haxeko/c3-wroom-air-quality/hardware/cost/price_db_and_boq.xlsx

Sheet: Kho gia
KHO GIÁ LINH KIỆN – dự án cảm biến PM2.5 (ESP32-C3)
Nguồn: đơn hàng Taobao (shop 优信电子), theo 2 ảnh chụp “Chi tiết đơn hàng”. Ngày cập nhật: 28/10/2026. |  |  |  |  |  |  |  |  |  |  |  |  | Tỷ giá USD → VND: | 26500 đ/USD
Giả định: số tiền ở mỗi dòng đơn hàng là THÀNH TIỀN của cả dòng (đã nhân số lượng), không phải đơn giá. Linh kiện dán bán theo gói 1件 = 50 chiếc (ghi trên ảnh sản phẩm).
Ô chữ xanh dương = số nhập tay từ đơn hàng (sửa được). Cột “Đơn giá / chiếc” tự tính = Thành tiền ÷ (SL mỗi gói × Số gói).
Dòng “Ước tính” (nền cam nhạt): chưa mua, giá tham khảo LCSC / thị trường quy ra VND theo tỷ giá ở ô O2. Khi mua thật, sửa Thành tiền và đổi Loại giá thành “Thực mua”.
ID | Tên linh kiện | Mã hàng / MPN | Thông số | Kiểu chân | SL mỗi gói (chiếc) | Số gói mua | Thành tiền (VND) | Tổng số chiếc | Đơn giá / chiếc (VND) | Nguồn | Ngày cập nhật | Dùng cho board PM2.5 | Ghi chú | Giá tham khảo (USD / chiếc) | Loại giá
LK001 | IC ổn áp AMS1117-3.3 | UMW AMS1117-3.3 | 3.3 V, 1 A | SOT-223 | 1 | 20 | 14256 đ | 20 | 712.8 đ | Taobao – 优信电子 | 28/10/2026 | Có | U2 |  | Thực mua
LK002 | Board ESP32-C3-SuperMini (chưa hàn chân) | ESP32-C3-SuperMini | Board phát triển | Module | 1 | 2 | 97416 đ | 2 | 48708.0 đ | Taobao – 优信电子 | 28/10/2026 | Không | Dùng thử nghiệm, không nằm trên board PM2.5 |  | Thực mua
LK003 | Tụ gốm 10 µF | Samsung CL21A106KAYNNNE | 10 µF ±10% 25 V X5R | 0805 | 50 | 1 | 46966 đ | 50 | 939.3 đ | Taobao – 优信电子 | 28/10/2026 | Có | C4, C16 |  | Thực mua
LK004 | Tụ gốm 22 µF | Samsung CL21A226MAQNNNE | 22 µF ±20% 25 V X5R | 0805 | 50 | 1 | 200337 đ | 50 | 4006.7 đ | Taobao – 优信电子 | 28/10/2026 | Có | C1, C3, C7 – lô đã mua (50 chiếc, đủ ~16 board). Lần mua sau dùng loại 16 V (LK028) |  | Thực mua
LK005 | Tụ gốm 100 nF | Samsung CL10B104KB8NNNC | 100 nF ±10% 50 V X7R | 0603 | 50 | 1 | 19642 đ | 50 | 392.8 đ | Taobao – 优信电子 | 28/10/2026 | Có | C2, C8, C10–C14, C18 |  | Thực mua
LK006 | Tụ gốm 1 µF | Samsung CL10B105KA8NNNC | 1 µF ±10% 25 V X7R | 0603 | 50 | 1 | 15920 đ | 50 | 318.4 đ | Taobao – 优信电子 | 28/10/2026 | Có | C6, C17 |  | Thực mua
LK007 | Điện trở 5.1 kΩ | UNI-ROYAL 0603WAF5101T5E | 5.1 kΩ ±1% 1/10 W | 0603 | 50 | 1 | 5307 đ | 50 | 106.1 đ | Taobao – 优信电子 | 28/10/2026 | Có | R1, R2 |  | Thực mua
LK008 | Điện trở 10 kΩ | UNI-ROYAL 0603WAF1002T5E | 10 kΩ ±1% 1/10 W | 0603 | 50 | 1 | 5307 đ | 50 | 106.1 đ | Taobao – 优信电子 | 28/10/2026 | Có | R3, R4, R5 |  | Thực mua
LK009 | Điện trở 4.7 kΩ | UNI-ROYAL 0603WAF4701T5E | 4.7 kΩ ±1% 1/10 W | 0603 | 50 | 1 | 5307 đ | 50 | 106.1 đ | Taobao – 优信电子 | 28/10/2026 | Có | R8, R9 (kéo lên I2C, có hàn) |  | Thực mua
LK010 | Điện trở 330 Ω | ROYALOHM 0603 3300 | 330 Ω ±1% 1/10 W | 0603 | 50 | 1 | 5307 đ | 50 | 106.1 đ | Taobao – 优信电子 | 28/10/2026 | Có | R7. Giả định gói 50 chiếc như các điện trở khác (ảnh không ghi) |  | Thực mua
LK011 | Điện trở 100 kΩ | UNI-ROYAL 0603WAF1003T5E | 100 kΩ ±1% 1/10 W | 0603 | 50 | 1 | 5307 đ | 50 | 106.1 đ | Taobao – 优信电子 | 28/10/2026 | Không | Không có trên board PM2.5 |  | Thực mua
LK012 | Cổng USB-C cái 6P | Type-C母座_6P_4脚插板7.4 | 6 chân, 4 chân vỏ xuyên lỗ, chỉ cấp nguồn | SMD + THT | 1 | 10 | 12672 đ | 10 | 1267.2 đ | Taobao – 优信电子 | 28/10/2026 | Không | Đã mua nhưng board v20 dùng cổng JLC hàn sẵn (LK029) |  | Thực mua
LK013 | Màn OLED 1.3" SH1106 | 1.3寸OLED显示屏_4针_白色 | 128×64, I2C 4 chân, chữ trắng | Module | 1 | 5 | 236016 đ | 5 | 47203.2 đ | Taobao – 优信电子 | 28/10/2026 | Có | Cắm vào J3 |  | Thực mua
LK014 | Board ESP32-H2-SuperMini | ESP32-H2-SuperMini | Board phát triển | Module | 1 | 2 | 158559 đ | 2 | 79279.5 đ | Taobao – 优信电子 | 28/10/2026 | Không | Không có trên board PM2.5 |  | Thực mua
LK015 | Module ESP32-C3-N4 (tương thích WROOM-02) | ESP32-C3-N4 (兼容 ESP32-C3-WROOM-02) | Wi-Fi + BLE, flash 4 MB | Module SMD | 1 | 10 | 373230 đ | 10 | 37323.0 đ | Taobao – giỏ hàng (chưa đặt) | 28/10/2026 | Có | Giá hiển thị 36.234 đ/chiếc (¥9,15); tổng giỏ 373.230 đ cho 10 chiếc (cao hơn 10 × đơn giá khoảng 10.890 đ, có thể là phí). Module tương thích, cần kiểm tra kích thước và chân khớp footprint WROOM-02 |  | Giỏ hàng
LK016 | LDO AP2112K-3.3 | Diodes AP2112K-3.3TRG1 (LCSC C51118) | 3.3 V 600 mA | SOT-23-5 | 1 | 1 | 450 đ | 1 | 450.0 đ | Giá chủ dự án cung cấp | 28/10/2026 | Có | Giá 450 đ / chiếc |  | Giá báo
LK017 | LED RGB XL-1615RGBC-WS2812B | XINGLIGHT XL-1615RGBC-WS2812B (LCSC C5349954) | RGB có IC, 1.6 x 1.5 mm | SMD 1615 | 1 | 1 | 300 đ | 1 | 300.0 đ | Giá chủ dự án cung cấp | 28/10/2026 | Có | 300 đ/chiếc là giá bạn báo cho LED 2020 trước đây; cập nhật khi có giá loại 1615 |  | Giá báo
LK018 | Cầu chì tự phục hồi 1.1 A | SMD1206-110 / SMD1206B110TFT | Giữ 1.1 A, ngắt 2.2 A, 6–8 V | 1206 | 1 | 1 | 600 đ | 1 | 600.0 đ | Giả định của chủ dự án | 28/10/2026 | Không | Không dùng cầu chì trên board (pad F1 nối tắt) |  | Ước tính
LK019 | Nút nhấn TS-1187A-B-A-B | XKB TS-1187A-B-A-B (LCSC C318884) | 5.1 x 5.1 mm, JLC Basic | SMD | 1 | 1 | 506.15 đ | 1 | 506.1 đ | Ước tính – LCSC | 28/10/2026 | Có | Giá LCSC khoảng 0,019 USD | 0.0191 USD | Ước tính
LK020 | Giắc JST-PH 2.0 4P đứng | B4B-PH-K-S (loại tương thích) | 4 chân, bước 2.0 mm, có khoá | THT | 1 | 1 | 600 đ | 1 | 600.0 đ | Giả định của chủ dự án | 28/10/2026 | Có | Nhóm giắc, nút, cầu chì giả định ~3.000 đ / sản phẩm, chia đều 600 đ cho 5 món (BOQ dùng 2 giắc) |  | Ước tính
LK021 | Header đực 1×6 2.54 mm + jumper | Header 1×6 + jumper 2.54 | 2.54 mm | THT | 1 | 1 | 600 đ | 1 | 600.0 đ | Giả định của chủ dự án | 28/10/2026 | Có | Nhóm giắc, nút, cầu chì giả định ~3.000 đ / sản phẩm, chia đều 600 đ cho 5 món |  | Ước tính
LK022 | Cảm biến bụi PMS5003 + đế chuyển + cáp | 攀藤 PMS5003+转接板+连接线 | PM1.0 / PM2.5 / PM10, UART 5 V; kèm đế chuyển và cáp | Module | 1 | 4 | 1022760 đ | 4 | 255690.0 đ | Taobao – đơn hàng đã nhận | 24/10/2026 | Có | Tiền hàng 1.013.760 đ + ship 9.000 đ cho 4 bộ (đã tính ship vào đơn giá) |  | Thực mua
LK023 | Module cảm biến CO2 SCD40 | Module SCD40 (I2C) | CO2 + nhiệt độ + độ ẩm | Module | 1 | 1 | 255000 đ | 1 | 255000.0 đ | Giá chủ dự án cung cấp | 28/10/2026 | Có | Giá 255.000 đ / module |  | Giá báo
LK024 | Cáp PH2.0 4P có dây sẵn | Cáp PH2.0 4P | Dài ~10–15 cm | Cáp | 1 | 1 | 2120 đ | 1 | 2120.0 đ | Ước tính – LCSC / thị trường | 28/10/2026 | Có | Ước tính | 0.08 USD | Ước tính
LK025 | PCB 2 lớp 51,4×31,4 mm (1 tấm) | JLCPCB 2 lớp 1.6 mm | Gia công PCB trần | PCB | 1 | 1 | 10600 đ | 1 | 10600.0 đ | Ước tính – LCSC / thị trường | 28/10/2026 | Có | Ước tính ~2 USD / 5 tấm, chưa gồm phí ship | 0.40 USD | Ước tính
LK026 | Vít M2 | Vít M2 (2 vít nhựa phía anten) | M2 | Vít | 1 | 1 | 530 đ | 1 | 530.0 đ | Ước tính – LCSC / thị trường | 28/10/2026 | Có | Ước tính | 0.02 USD | Ước tính
LK027 | Vỏ hộp in 3D | Nhựa PLA ~40 g | Tự in 3D | Vỏ | 1 | 1 | 12000 đ | 1 | 12000.0 đ | Ước tính – LCSC / thị trường | 28/10/2026 | Có | Chỉ tiền nhựa nếu tự in; thuê in sẽ cao hơn |  | Ước tính
LK028 | Tụ gốm 22 µF 16 V | Samsung CL21A226MOQNNNE (LCSC C98190) | 22 µF ±20% 16 V X5R | 0805 | 1 | 1 | 662.5 đ | 1 | 662.5 đ | Ước tính – LCSC / thị trường | 28/10/2026 | Có | Thay tụ 22 µF 25 V cho C1, C3, C7 (cùng footprint 0805). Giá ước tính, sửa khi mua thật | 0.025 USD | Ước tính
LK029 | Cổng USB-C 16P (JLC hàn) | HX TYPE-C 16PIN (LCSC C2927039) | 16P, chỉ dùng VBUS/GND/CC | SMD + chân vỏ xuyên lỗ | 1 | 1 |  | 1 | 0.0 đ | JLCPCB | 28/10/2026 | Có | Chưa có giá – xem trên công cụ BOM của JLC rồi nhập vào Thành tiền |  | Chưa có giá
 |  |  |  |  |  | Tổng tiền đơn hàng | 1851079 đ

Sheet: BOQ 1 san pham
BOQ – GIÁ THÀNH 1 SẢN PHẨM CẢM BIẾN PM2.5 (Air Quality V1.0)
Ô nền vàng, chữ xanh dương = nhập tay đơn giá cho linh kiện chưa có trong Kho giá (VND / chiếc). Để trống = chưa có giá.
Chữ xanh lá = đơn giá tự lấy từ sheet “Kho gia” theo cột Mã kho. Cột SL / sản phẩm sửa được (chữ xanh dương).
Thành tiền = SL × Đơn giá áp dụng. Trạng thái: “Đã có giá” = giá thực mua; “Giá ước tính” = chưa mua, giá tham khảo trong Kho gia.
STT | Nhóm | Ký hiệu | Mô tả | SL / sản phẩm | Mã kho | Đơn giá nhập tay (VND) | Đơn giá áp dụng (VND) | Thành tiền (VND) | Trạng thái | Ghi chú
1 | Linh kiện trên board | U1 | Module ESP32-C3-N4 (tương thích ESP32-C3-WROOM-02) | 1 | LK015 |  | 37323.0 đ | 37323 đ | Đã có giá | Tự hàn, không đặt JLC (mua riêng trên Taobao)
2 | Linh kiện trên board | U2 | IC ổn áp AMS1117-3.3, SOT-223 | 1 | LK001 |  | 712.8 đ | 712.8 đ | Đã có giá
3 | Linh kiện trên board | U6 | LDO AP2112K-3.3 (nguồn riêng SCD40), SOT-23-5 | 1 | LK016 |  | 450.0 đ | 450 đ | Đã có giá
4 | Linh kiện trên board | LED1–LED3 | LED RGB XL-1615RGBC-WS2812B (1.6 x 1.5 mm) | 3 | LK017 |  | 300.0 đ | 900 đ | Đã có giá
5 | Linh kiện trên board | C1, C3, C7 | Tụ 22 µF 16 V X5R 0805 | 3 | LK028 |  | 662.5 đ | 1987.5 đ | Giá ước tính
6 | Linh kiện trên board | C4, C16 | Tụ 10 µF 25 V X5R 0805 | 2 | LK003 |  | 939.3 đ | 1878.64 đ | Đã có giá
7 | Linh kiện trên board | C2, C8, C10–C12, C18 | Tụ 100 nF 50 V X7R 0603 | 6 | LK005 |  | 392.8 đ | 2357.04 đ | Đã có giá
8 | Linh kiện trên board | C6, C17 | Tụ 1 µF 25 V X7R 0603 | 2 | LK006 |  | 318.4 đ | 636.8 đ | Đã có giá
9 | Linh kiện trên board | R1, R2 | Điện trở 5.1 kΩ 1% 0603 (CC USB-C) | 2 | LK007 |  | 106.1 đ | 212.28 đ | Đã có giá
10 | Linh kiện trên board | R3, R4, R5 | Điện trở 10 kΩ 1% 0603 | 3 | LK008 |  | 106.1 đ | 318.42 đ | Đã có giá
11 | Linh kiện trên board | R7 | Điện trở 330 Ω 1% 0603 (data LED) | 1 | LK010 |  | 106.1 đ | 106.14 đ | Đã có giá
12 | Linh kiện trên board | R8, R9 | Điện trở 4.7 kΩ 1% 0603 (kéo lên I2C) | 2 | LK009 |  | 106.1 đ | 212.28 đ | Đã có giá | Có hàn (song song điện trở kéo lên trên module, vẫn trong mức an toàn)
13 | Linh kiện trên board | F1 | Điện trở 0 Ω 1206 thay cầu chì (JLC C17888) | 1 |  | 60 đ | 60.0 đ | 60 đ | Đã có giá | Ước tính khoảng 60 đ
14 | Linh kiện trên board | SW2 | Nút nhấn TS-1187A-B-A-B (JLC Basic) | 1 | LK019 |  | 506.1 đ | 506.15 đ | Giá ước tính
15 | Linh kiện trên board | J1 | Cổng USB-C 16P HX (JLC C2927039, JLC hàn) | 1 | LK029 |  | 0.0 đ | 0 đ | Chưa có giá
16 | Linh kiện trên board | J2B, J4 | Giắc JST-PH 2.0 mm 4P cắm đứng | 2 | LK020 |  | 600.0 đ | 1200 đ | Giá ước tính
17 | Linh kiện trên board | J5 | 6 pad nạp (không còn header + jumper) | 0 | LK021 |  | 600.0 đ | 0 đ | Không dùng | Đã đổi thành pad trên board, không tốn linh kiện
18 | Module & cảm biến | J3 | Màn OLED 1.3" SH1106 I2C | 1 | LK013 |  | 47203.2 đ | 47203.2 đ | Đã có giá
19 | Module & cảm biến | — | Cảm biến bụi PMS5003 (kèm đế chuyển + cáp) | 1 | LK022 |  | 255690.0 đ | 255690 đ | Đã có giá
20 | Module & cảm biến | — | Module cảm biến CO2 SCD40 | 1 | LK023 |  | 255000.0 đ | 255000 đ | Đã có giá
21 | Module & cảm biến | — | Cáp JST-PH 4P có dây (PMS5003, SCD40) | 2 | LK024 |  | 2120.0 đ | 4240 đ | Giá ước tính
22 | PCB & gia công | — | PCB trần (giá 1 tấm theo báo giá JLCPCB) | 1 | LK025 |  | 10600.0 đ | 10600 đ | Giá ước tính | Thay bằng tổng tiền PCB ÷ số tấm khi có báo giá
23 | PCB & gia công | — | Phí lắp ráp SMT JLC (chia cho 1 tấm) | 0 |  |  | 0.0 đ | 0 đ | Không dùng | Mặc định 0 = tự hàn. Nếu JLC hàn: SL = 1, nhập phí, và linh kiện JLC cấp không tính lại ở trên
24 | Vỏ & vật tư phụ | H1–H4 | Vít M2 (2 con bên phải nên là vít nhựa) | 4 | LK026 |  | 530.0 đ | 2120 đ | Giá ước tính
25 | Vỏ & vật tư phụ | — | Vỏ hộp | 1 | LK027 |  | 12000.0 đ | 12000 đ | Giá ước tính
 |  |  | TỔNG HỢP
 |  |  | Linh kiện trên board |  |  |  |  | 48861.05 đ | 1 dòng chưa có giá
 |  |  | Module & cảm biến |  |  |  |  | 562133.2 đ | 0 dòng chưa có giá
 |  |  | PCB & gia công |  |  |  |  | 10600 đ | 0 dòng chưa có giá
 |  |  | Vỏ & vật tư phụ |  |  |  |  | 14120 đ | 0 dòng chưa có giá
 |  |  | GIÁ THÀNH 1 SẢN PHẨM |  |  |  |  | 635714.25 đ | 1 dòng chưa có giá
 |  |  | trong đó: theo giá thực mua |  |  |  |  | 603060.6 đ
 |  |  | trong đó: theo giá ước tính |  |  |  |  | 32653.65 đ
 |  |  | Giá ước tính đổi theo tỷ giá ở ô O2 sheet Kho gia. Khi mua thật, cập nhật Kho gia là BOQ tự tính lại.
