haxeko/c3-wroom-air-quality/hardware/mechanical/board_outline.dxf

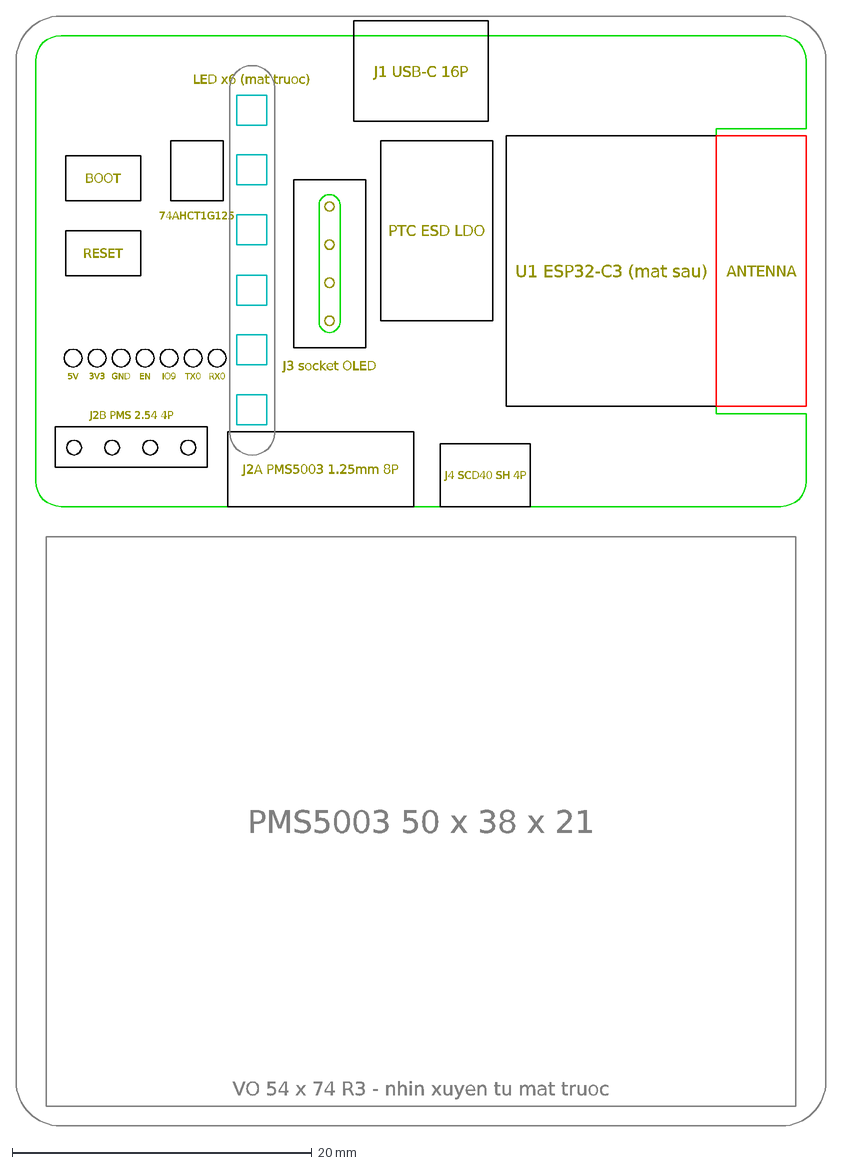
[picture p2: CAD file, 2026-11-11]
hardware/mechanical/board_outline.dxf
LED x6 (mat truoc)
U1 ESP32-C3 (mat sau)
ANTENNA
J1 USB-C 16P
PTC ESD LDO
J3 socket OLED
74AHCT1G125
BOOT
RESET
5V
3V3
GND
EN
IO9
TX0
RX0
J2B PMS 2.54 4P
J2A PMS5003 1.25mm 8P
J4 SCD40 SH 4P
PMS5003 50 x 38 x 21
VO 54 x 74 R3 - nhin xuyen tu mat truoc
