haxeko/c3-wroom-air-quality/hardware/kicad/led2020/pm25_LED2020.kicad_pcb

## KiCad design hardware/kicad/led2020/pm25_LED2020.kicad_pcb (2026-11-11)

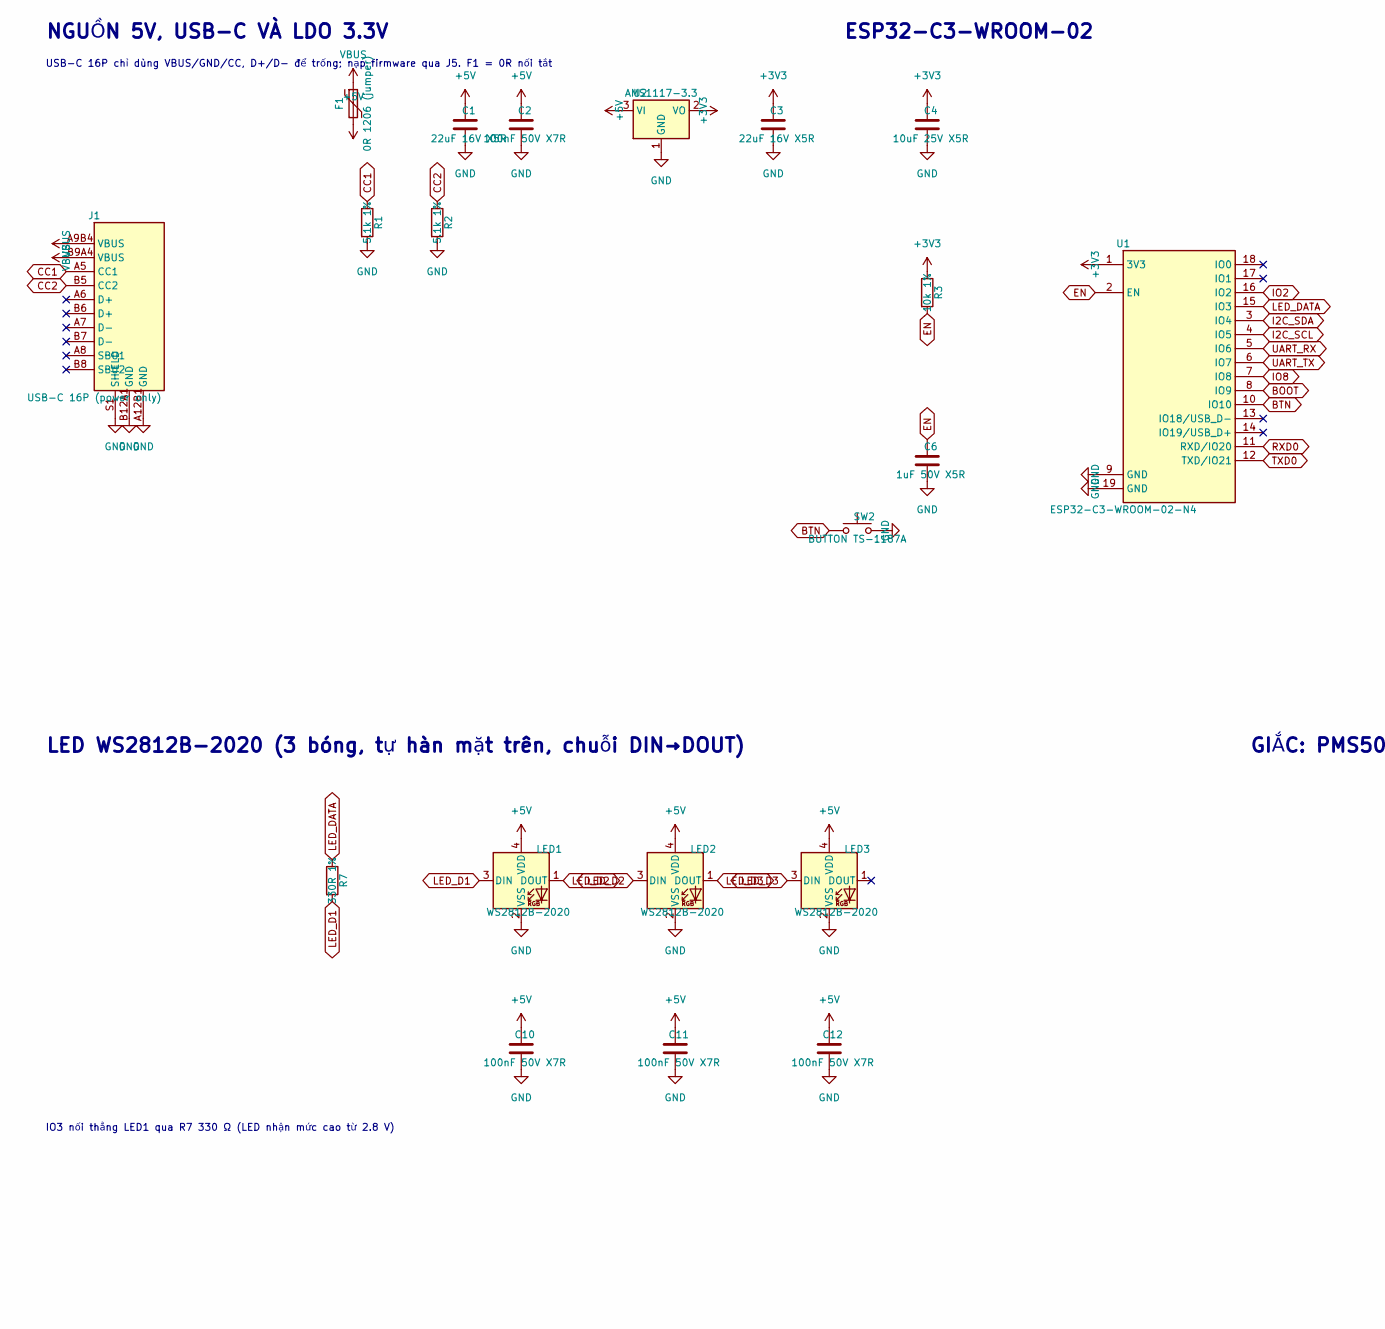
[picture p15: schematic pm25_LED2020.kicad_sch, Cảm biến bụi PM2.5 - ESP32-C3 - LED2020, part in row 1, column 1]

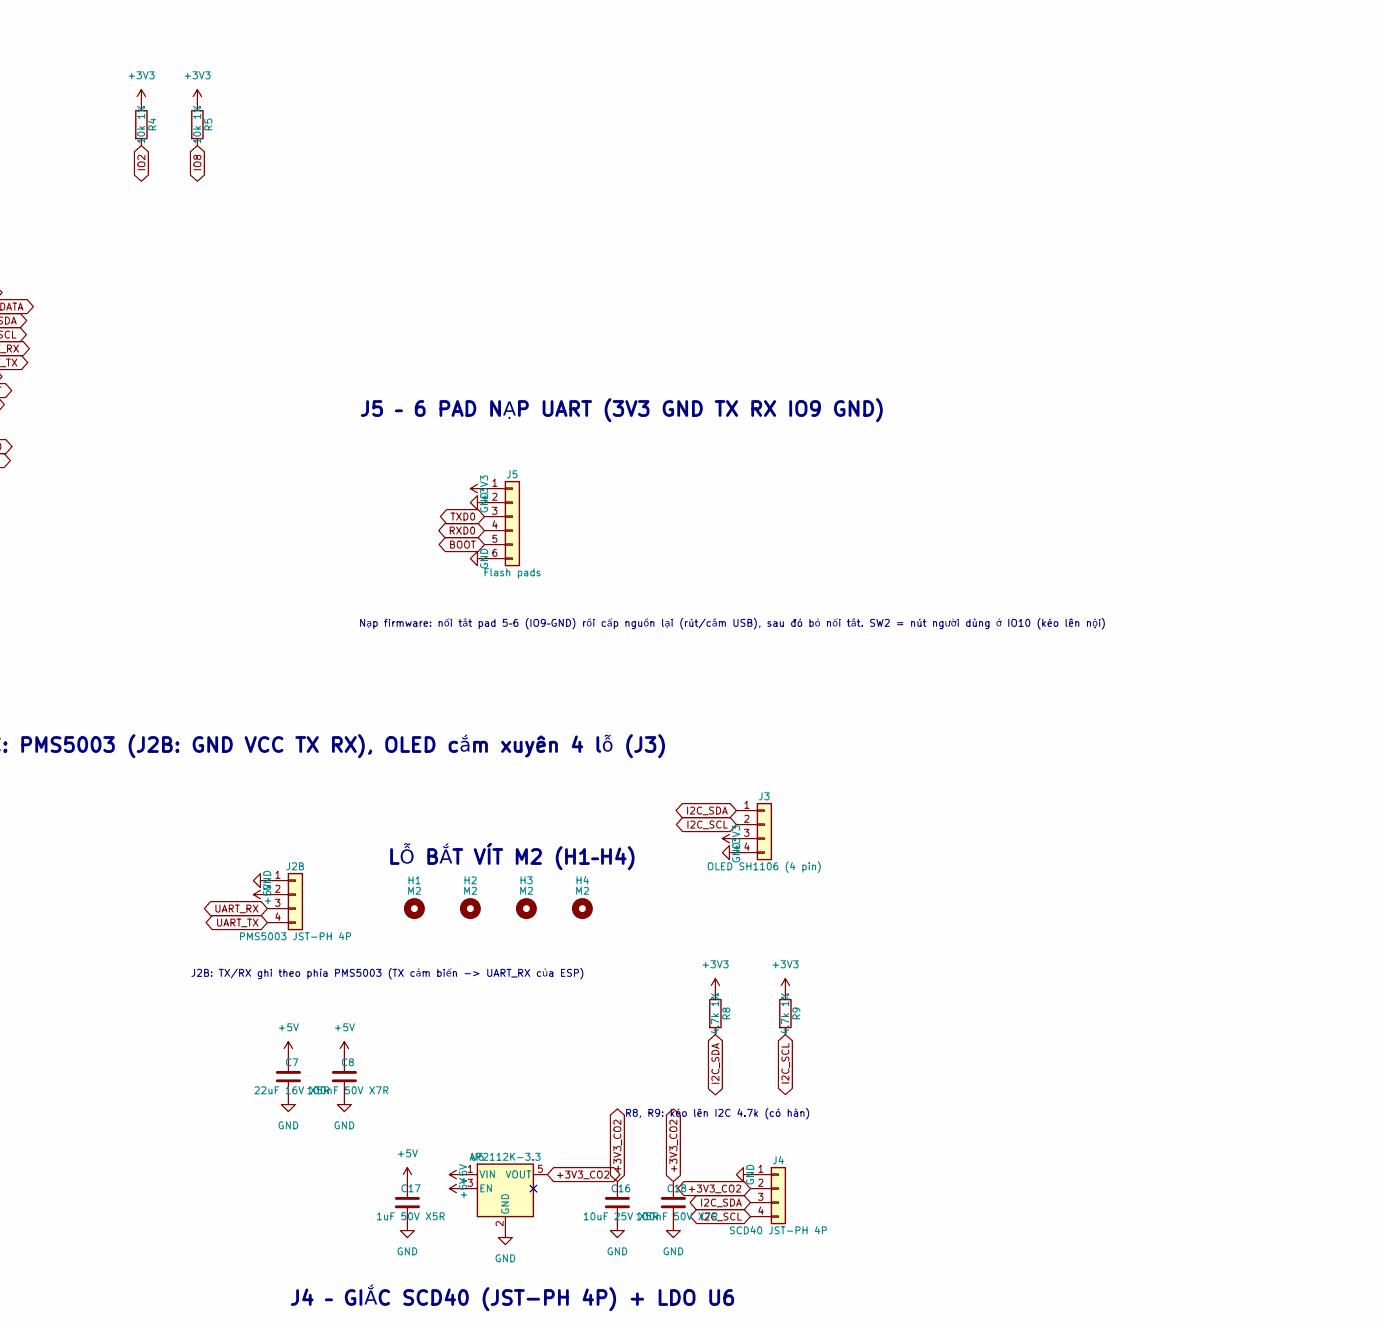
[picture p16: schematic pm25_LED2020.kicad_sch, Cảm biến bụi PM2.5 - ESP32-C3 - LED2020, part in row 1, column 2]

Parts:
C1, C3, C7: 22uF 16V X5R; C_0805_2012Metric
C2, C8, C10, C11, C12, C18: 100nF 50V X7R; C_0603_1608Metric
C4, C16: 10uF 25V X5R; C_0805_2012Metric
C6, C17: 1uF 50V X5R; C_0603_1608Metric
F1: 0R 1206 (jumper); Fuse_1206_3216Metric
H1, H2, H3, H4: M2; MountingHole_2.2mm_M2
J1: USB-C 16P (power only); USB_C_HX_TYPE-C-16PIN
J2B: PMS5003 JST-PH 4P; JST_PH_B4B-PH-K_1x04_P2.00mm_Vertical
J3: OLED SH1106 (4 pin); PinHeader_1x04_P2.54mm_Vertical
J4: SCD40 JST-PH 4P; JST_PH_B4B-PH-K_1x04_P2.00mm_Vertical
J5: Flash pads; Flash_Pads_1x06_P2.54mm
LED1, LED2, LED3: WS2812B-2020; LED_WS2812B-2020_PLCC4_2.0x2.0mm
R1, R2: 5.1k 1%; R_0603_1608Metric
R3, R4, R5: 10k 1%; R_0603_1608Metric
R7: 330R 1%; R_0603_1608Metric
R8, R9: 4.7k 1%; R_0603_1608Metric
SW2: BUTTON TS-1187A; SW_Push_1P1T_XKB_TS-1187A
U1: ESP32-C3-WROOM-02-N4; ESP32-C3-WROOM-02
U2: AMS1117-3.3; SOT-223-3_TabPin2
U6: AP2112K-3.3; SOT-23-5

Connections:
+3V3: C3.1, C4.1, J3.3, J5.1, R3.1, R4.1, R5.1, R8.1, R9.1, U1.1 (3V3), U2.2 (VO)
+3V3_CO2: C16.1, C18.1, J4.2, U6.5 (VOUT)
+5V: C1.1, C2.1, C7.1, C8.1, C10.1, C11.1, C12.1, C17.1, F1.2, J2B.2, LED1.4 (VDD), LED2.4 (VDD), LED3.4 (VDD), U2.3 (VI), U6.1 (VIN), U6.3 (EN)
BOOT: J5.5, U1.8 (IO9)
BTN: SW2.1, U1.10 (IO10)
CC1: J1.A5 (CC1), R1.1
CC2: J1.B5 (CC2), R2.1
EN: C6.1, R3.2, U1.2 (EN)
GND: C1.2, C2.2, C3.2, C4.2, C6.2, C7.2, C8.2, C10.2, C11.2, C12.2, C16.2, C17.2, C18.2, J1.A12B1 (GND), J1.B12A1 (GND), J1.S1 (SHIELD), J2B.1, J3.4, J4.1, J5.2, J5.6, LED1.2 (VSS), LED2.2 (VSS), LED3.2 (VSS), R1.2, R2.2, SW2.2, U1.9 (GND), U1.19 (GND), U2.1 (GND), U6.2 (GND)
I2C_SCL: J3.2, J4.4, R9.2, U1.4 (IO5)
I2C_SDA: J3.1, J4.3, R8.2, U1.3 (IO4)
IO2: R4.2, U1.16 (IO2)
IO8: R5.2, U1.7 (IO8)
LED_D1: LED1.3 (DIN), R7.2
LED_D2: LED1.1 (DOUT), LED2.3 (DIN)
LED_D3: LED2.1 (DOUT), LED3.3 (DIN)
LED_DATA: R7.1, U1.15 (IO3)
RXD0: J5.4, U1.11 (RXD/IO20)
TXD0: J5.3, U1.12 (TXD/IO21)
UART_RX: J2B.3, U1.5 (IO6)
UART_TX: J2B.4, U1.6 (IO7)
VBUS: F1.1, J1.A9B4 (VBUS), J1.B9A4 (VBUS)

Notes on the sheet:
NGUỒN 5V, USB-C VÀ LDO 3.3V
USB-C 16P chỉ dùng VBUS/GND/CC, D+/D- để trống; nạp firmware qua J5. F1 = 0R nối tắt
ESP32-C3-WROOM-02
J5 – 6 PAD NẠP UART (3V3 GND TX RX IO9 GND)
Nạp firmware: nối tắt pad 5–6 (IO9–GND) rồi cấp nguồn lại (rút/cắm USB), sau đó bỏ nối tắt. SW2 = nút người dùng ở IO10 (kéo lên nội)
LED WS2812B-2020 (3 bóng, tự hàn mặt trên, chuỗi DIN→DOUT)
GIẮC: PMS5003 (J2B: GND VCC TX RX), OLED cắm xuyên 4 lỗ (J3)
R8, R9: kéo lên I2C 4.7k (có hàn)
J4 – GIẮC SCD40 (JST-PH 4P) + LDO U6
LỖ BẮT VÍT M2 (H1–H4)
J2B: TX/RX ghi theo phía PMS5003 (TX cảm biến -> UART_RX của ESP)
IO3 nối thẳng LED1 qua R7 330 Ω (LED nhận mức cao từ 2.8 V)

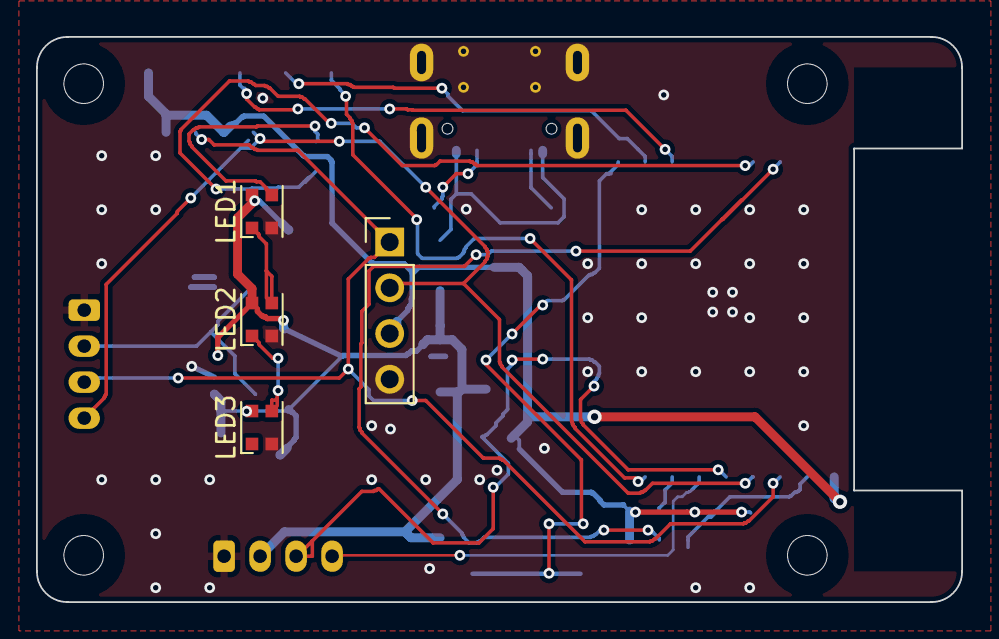
[picture p17: board pm25_LED2020.kicad_pcb from above]

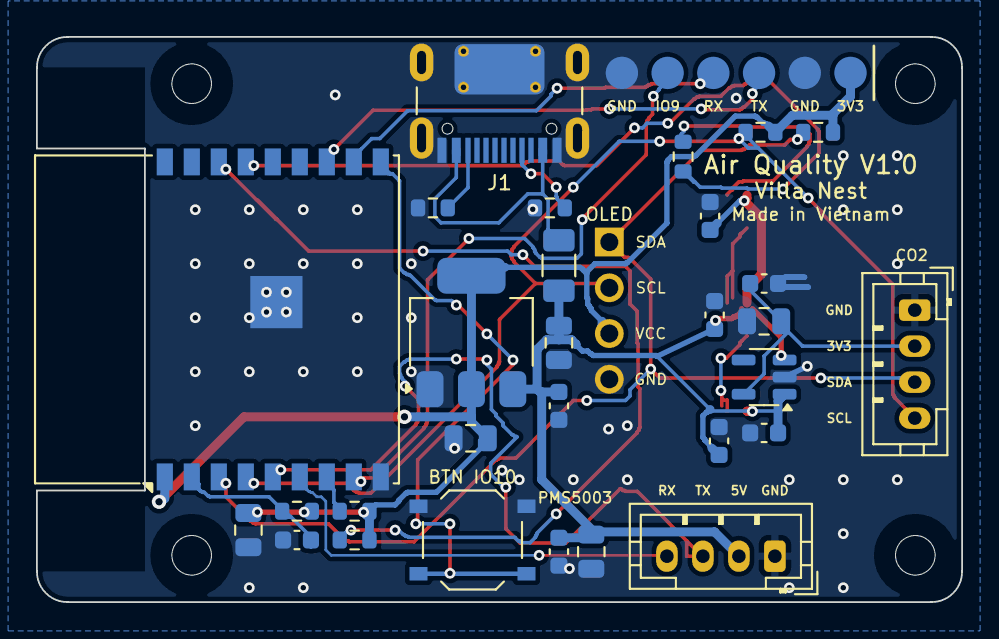
[picture p18: board pm25_LED2020.kicad_pcb from below]

Board: 2 copper layers, 51.4 x 31.4 mm, 38 parts (30 on the bottom side), 22 nets.
