haxeko/c3-wroom-air-quality/(commit log)

2026-10-15 Copy the PM2.5 sensor project to ESP32-C3/matter-pm25-sensor
    Exact copy of ESP32-C3/matter-wifi/matter-pm25-sensor (replacing the
    placeholder README), as the base of a version without the LD2410 radar.
    The next commit holds the changes, so they can be reviewed on their own.
    Claude-Session: https://claude.ai/code/session_01QSoK8V8ZeqyoMRrKyMSBbg
    [partitions.csv]
2026-10-15 PM2.5 sensor without radar: a button turns the OLED on and off
    New version in ESP32-C3/matter-pm25-sensor for builds without the LD2410
    radar. Matter, the PM sensor, LEDs and the factory reset button are
    unchanged.
    - Display button on CONFIG_DISPLAY_BUTTON_GPIO (default GPIO3, the old
    radar wire): each press flips what the screen shows, at the press
    rather than the release, and ends the start-up screen. The OLED is still
    on during start-up (first value + 5 s) and during a factory reset.
    - The choice is saved in NVS ("local_ui"/"display_on") and applies after
    a restart; without a button (-1) the OLED stays on.
    - button.cpp supports two buttons, each polled by its own esp_timer, and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
    [app_main.cpp, test_local_ui.cpp]
2026-10-28 PM2.5 sensor without radar: default pins of the PCB
    The PCB of ESP32-C3/matter-pm25-sensor wires:
    - PMS5003 on connector J2B: sensor TX -> GPIO6 (UART1 RX), sensor RX <-
    GPIO7 (UART1 TX), was GPIO20/21
    - OLED SDA/SCL on GPIO4/5, was GPIO8/9
    - WS2812 data on GPIO3, was GPIO10
    - no display button and no factory reset button: both default to -1, so
    the OLED stays on and factory reset is done with 5 quick power cycles.
    Kconfig defaults, sdkconfig.defaults, comments, README (pin table of the
    PCB instead of the hand-wiring diagram, which showed the old pins) and the
    host test pins follow. The flash file tag becomes "pcb". GPIO8/9 (strapping
    pins) are no longer used. An existing sdkconfig keep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
    [app_main.cpp, test_local_ui.cpp]
2026-10-28 PM2.5 PCB: SSD1306 OLED, upright with the pin header on top
    The PCB carries a 0.96" OLED module, an SSD1306, not the 1.3" SH1106 the
    driver was written for. The SSD1306 has 128 columns, so the SH1106 column
    offset of 2 shifted the image and wrapped the last 2 columns onto the
    first ones: garbage along one edge. New "OLED controller" choice
    (SSD1306 by default, SH1106 for 1.3" modules) sets the offset to 0 or 2;
    the commands are otherwise the same.
    The module sits with its pin header on top, so the image was upside down:
    "Rotate OLED 180 degrees" now defaults to off.
    Host tests check the column address for both controllers.
    Claude-Ses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
2026-10-28 PM2.5 PCB: SCD40/41 CO2 sensor, PM2.5 + CO2 screen, button on GPIO10
    - CO2: Sensirion SCD40/SCD41 driver on the I2C bus now shared with the OLED
    (i2c_bus), periodic measurement averaged over 30 s (Kconfig), silent probe
    while missing, restart after a power glitch, CRC checked.
    - Matter: Carbon Dioxide Concentration Measurement cluster (ppm, 0-40000) on
    the air quality endpoint. AirQuality, OLED level and LEDs still follow PM2.5
    only. CO2_SENSOR=None builds the previous device.
    - OLED: PM2.5 + CO2 screen (names on top, values below, no units; default
    with a CO2 sensor) or PM2.5 alone as before; "--" without a value; pairing
    screen "CHỜ GHÉP NỐI" with the manual pairing code.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
    [app_main.cpp]
2026-10-28 PM2.5 + CO2 screen: both values always the same size
    A CO2 value above 9999 ppm used to switch to a smaller font on its own. Both
    values now share one font: the large one, unless together they do not fit on
    the line (e.g. PM2.5 1000 and CO2 10000), and then both take the smaller one.
    sh1106_text_width() is now public for that.
    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
    [test_local_ui.cpp]
2026-10-30 PM2.5 PCB: log reset reason, Wi-Fi disconnect reason and stack headroom
    Diagnostics for 24/7 operation, from the firmware audit (no behavior change):
    - boot log prints the reset reason (power-on, software, task watchdog,
    brown-out...), to tell a crash or watchdog from a power cycle;
    - WIFI_EVENT_STA_DISCONNECTED handler logs the wifi_err_reason_t code and
    the RSSI (the Matter stack logs the event without them);
    - the 30 s status log adds the smallest free stack of the local_ui,
    pm_sensor, scd4x, CHIP, esp_timer and sys_evt tasks, in bytes.
    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
    [app_main.cpp]
2026-11-10 PM2.5 PCB: commissioning diagnostics build, PMS sleep retry, OLED init in the UI task
    From the review of "sensors plugged in: fan never stops, no commissioning".
    No change to pins, partition table, Matter data model or stored data formats.
    Fixes:
    - PMS5003: the sleep command was sent once. When it was lost, or the sensor
    was plugged in or restarted while "asleep", the fan ran until the next
    period (5 minutes). Frames that still arrive 5 s after the command now make
    the driver send it again (logged for the first one, then once a minute).
    - PM sensor UART: pull-up on RX. uart_set_pin() of ESP-IDF 5.4 leaves the pad
    without a pull, so it floated with the sensor unplugged.
    - The UI task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
    [app_main.cpp]
2026-11-10 PM2.5 PCB diagnostics: brown-out threshold overlay, test plan details
    - sdkconfig.diag.bod: diagnostics build that resets at about 2.92 V instead
    of 2.51 V. The module needs 3.0 V, so its brown-out count shows a 3.3 V rail
    that dips below that without an oscilloscope (test case I). Its firmware
    files are named ..._diag_bod4_...
    - Test plan: case D2 (pair once the fan has stopped), expected values of the
    PM frame counters and of the I2C transfer time, what "matter esp wifi
    connect" leaves behind, what an update file does not replace (bootloader
    log), LED load, flashing over UART0.
    Claude-Session: https://claude.ai/code/session_01QSoK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
2026-11-10 Own repository: project at the root, build numbers go on from 191
    The project comes from ESP32-C3/matter-pm25-sensor of haxeko/ESP32-IoT-Project
    (branch claude/epic-gates-m4pswo, commit 04ca33c, firmware 1.0.191), with the
    commits of its own history. No change to the firmware sources.
    - The build number is the number of commits, which starts again here.
    FIRMWARE_BUILD_OFFSET (181) is added to it, so that this commit is 1.0.192
    and devices running a build of the old repository still take a newer one as
    an update (the build number is the Matter SoftwareVersion that OTA compares).
    - README: clone and build from this repository, the radar version is linked
    in the old repository.
    Co-Aut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
2026-11-11 Firmware in firmware/, as in the repository layout of the README
    The web upload (2af3285) replaced the firmware README and .gitignore at the
    root with those of the whole repository. The firmware now sits in firmware/,
    next to the hardware/ and docs/ folders the README describes:
    - firmware sources moved with their history (git log --follow);
    - firmware/README.md and firmware/.gitignore: the firmware README and ignore
    rules from before the upload, with the clone path now ending in firmware/;
    - README.md: firmware line of the folder tree and the quick start point at
    the firmware instead of "no code yet".
    .gitattributes and .gitignore at the root stay as uploaded. No change to the
    firmwar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
    [partitions.csv]
2026-11-11 Firmware defaults for the board (SH1106, 3 LEDs); fixes from the hardware review
    Firmware:
    - Kconfig defaults follow the PCB: OLED controller SH1106 (1.3") instead of
    SSD1306, 3 WS2812 LEDs instead of 6. Delete an existing sdkconfig to get
    them. No other change to the sources.
    - README: OLED, LEDs, connectors (J3, J4, J5, SW2) and how to flash this
    board through the J5 pads, as its USB port only powers it.
    - Test plan: console on the J5 pads, the CO2 sensor's own regulator (U6),
    LED current from the LED datasheet, measuring points of the board, and a
    new case J without the OLED, which sits over the antenna area.
    Hardware documents, checked against the board files:
    - assembly-jlcpc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
    [bom_full.csv]
2026-11-11 Test plan: display on wires, sensors away from the board
    The OLED is wired to the board, not mounted over the antenna, and the
    PMS5003 sits away from it on its cable: cases H and J and what to conclude
    from them now say so. Check that each cable is in its own connector, as
    J4 (CO2) and J2B (PMS5003) are the same 4-pin type next to each other.
    Documentation only: the firmware is the same as 1.0.197.
    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
